professorrichardson/Irriga-o-da-Horta/esp-interativo.png

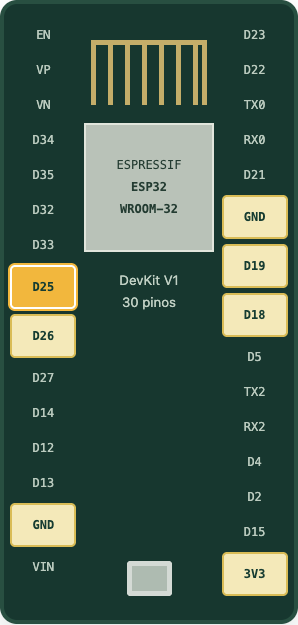
esp-interativo.png
